Ahmedvini/HyperConv/clockInfo.txt

-------------------------------------
| Tool Version : Vivado v.2025.2
| Date         : Tue Sep 15 03:39:24 2026
| Host         : pop-os
| Design       : design_1
| Device       : xc7z020-clg400-1--
-------------------------------------

For more information on clockInfo.txt clock routing debug file see https://support.xilinx.com/s/article/000035660?language=en_US
