Ahmedvini/HyperConv/bitstream/impl_1/.vivado.begin.rst

<?xml version="1.0"?>
<ProcessHandle Version="1" Minor="0">
    <Process Command="vivado" Owner="ahmedelsheikh" Host="pop-os" Pid="770740" HostCore="12" HostMemory="16089012">
    </Process>
</ProcessHandle>
