Ahmedvini/HyperConv/docs/Images/base/package-view.png

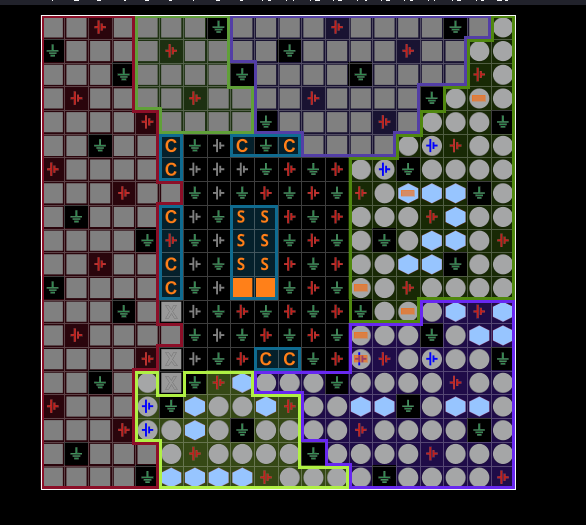
docs/Images/base/package-view.png
