Ahmedvini/HyperConv/docs/Images/base/schematic.png

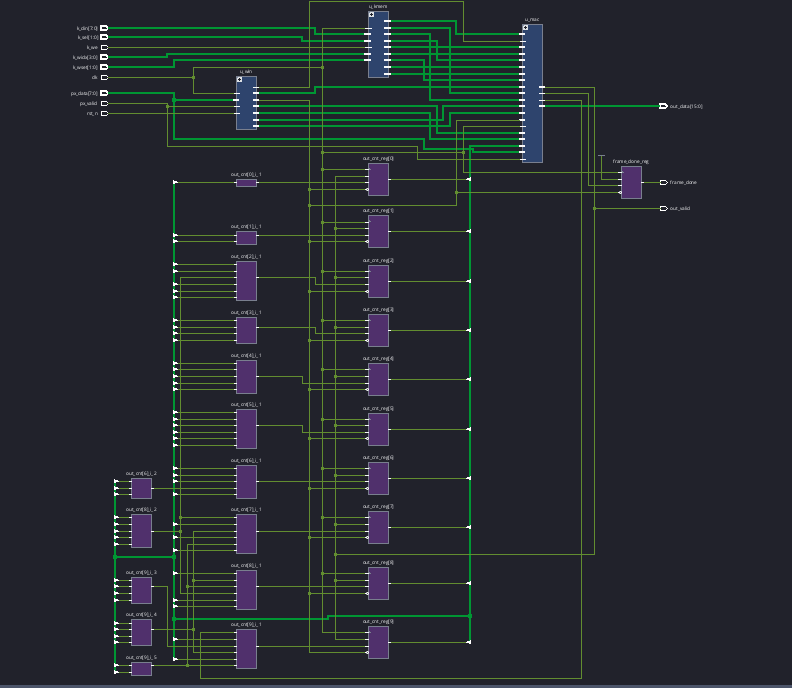
docs/Images/base/schematic.png
