Ahmedvini/HyperConv/(commit log)

2026-07-08 Add Sobel filter test cases and synthesis scripts
    - Introduced new test images and expected output files for Sobel X and Y filters.
    - Added hex files for input images, kernels, and expected outputs.
    - Created parameter script for Sobel Y tests to define image dimensions and kernel settings.
    - Implemented a build script for synthesis of the convolution top module with out-of-context constraints.
    - Added a testbench for the convolution top module to validate functionality against expected outputs.
    - Included XDC constraints for the ZCU106 target to set clock parameters.
2026-07-09 Add self-test functionality and board integration for standalone demo
2026-09-14 Update README, report skeleton, and RTL files for PYNQ-Z2 support; adjust clock constraints and pipeline stages
2026-09-14 Update clockInfo.txt date and remove unnecessary load settings in board.xdc
2026-09-14 Update latency and power metrics in documentation; adjust clockInfo.txt date
2026-09-14 Add ReLU test cases for negative and random inputs
    - Created new test files for ReLU negative inputs including img.hex, kernel.hex, and params.sh.
    - Added expected output for random inputs in expected.hex.
    - Introduced img.hex, kernel.hex, and params.sh for random inputs.
    - Each test case is configured with parameters for dimensions and activation functions.
2026-09-14 Update device and package view images for improved documentation clarity
2026-09-14 Add synthesis reports and scripts for board_top design
    - Created board_top_utilization_synth.rpt to report utilization metrics.
    - Added gen_run.xml to define the synthesis run configuration and file dependencies.
    - Included htr.txt for a repeatable run description of the Vivado synthesis process.
    - Generated rundef.js for WSH script execution with environment setup.
    - Added runme.bat for Windows batch execution of the synthesis process.
    - Created runme.sh for UNIX-based execution of the synthesis process.
2026-09-14 Remove synthesized report files and associated scripts from the bitstream directory. Update board constraints to specify package pins for clock, reset, and status LEDs.
    [board.xdc]
2026-09-15 Add isolated DMP dual-multiply packing experiment (Step 1-2)
    Packs two u8 pixels into the DSP48E1 25-bit A port (stride 16) with a
    single shared s8 coefficient in B: one DSP computes both products.
    Extraction: low field is exact s16; high field needs a +1 borrow
    correction (+prod[15]).
    Verified: 101,276 vectors (all corners incl. 255*-128, full coeff sweep,
    100k random, continuous + gapped valids) - 0 errors.
    Synthesis (xc7z020clg400-1): exactly 1 DSP48E1 inferred, 3 LUT / 36 FF.
    Note: arbitrary two-product packing (separate coeffs) is infeasible on
    DSP48E1 (18-bit B port forces stride <= 10 -> cross-term contamination);
    shared-coefficient packing maps exactly onto two adjacent windows of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
    [dmp_probe.v, ooc.xdc, tb_dmp_probe.v]
2026-09-15 Add hybrid 2-px/cycle architecture: window_gen_2px + dmp_mac_array + conv_top_hybrid
    - window_gen_2px: even/odd interleaved LUTRAM line buffers (zero BRAM),
    (N+1)-wide row shifter, two adjacent windows per beat
    - dmp_mac_array: 9 packed DSP multiplies (both windows share coeffs),
    extraction + borrow correction, two adder trees, dual saturate/ReLU
    - conv_top_hybrid: same feature set as baseline, 2 px in / 2 px out
    - tb_conv_top_hybrid + run_all_hybrid.sh: reuses all 11 golden testcases
    Verified: 11/11 PASS bit-exact (gaps, n5, saturation, ReLU, Sobel).
    Pipeline latency 7 cycles (1 window + 6 MAC).
    [conv_top_hybrid.v, dmp_mac_array.v, tb_conv_top_hybrid.v, window_gen_2px.v]
2026-09-15 Add hybrid board-demo wrapper: selftest_top_hybrid + board_top_hybrid + bitstream flow
    - selftest_top_hybrid: streams the stored image as px0/px1 pairs, compares
    both beat outputs on-chip against the SAME expected.hex as baseline
    - board_top_hybrid: identical pin usage to board_top (reuses board.xdc)
    - tb_selftest_hybrid: sim PASS (542 cycles, ~2x faster than baseline's
    ~1030 - confirms 2-px operation)
    - build_bitstream_hybrid.tcl: sobel_x demo built for PYNQ-Z2:
    579 LUT / 597 FF / 9 DSP / 0 BRAM, WNS +3.068 @ 100 MHz, DRC clean
    (ZPS7-1 advisory only, same as baseline), 4.0 MB bitstream.
2026-09-15 Docs: hybrid board-demo results (sim PASS 542 cyc, bitstream built, board.xdc reused)
2026-09-15 Ignore stray clockInfo in hybrid board build dir
2026-09-15 Upgrade hybrid architecture diagram with full internals
    - expanded mac_array / dmp_mac_array sub-blocks (packed DSPs, extraction
    + borrow fix, dual adder trees, dual sat/ReLU)
    - pipeline stage rulers (6 baseline / 7 hybrid) with per-stage labels
    - DMP packing equation panel, verification + board-demo footnote
    - fixed label/stat line collisions
2026-09-15 Reorganize Vivado images into base/ + hybrid/, update all docs
    - docs/Images/base/: baseline utilization/timing/power/methodology,
    device/package views, schematic, waveforms
    - docs/Images/hybrid/: hybrid OOC report captures (365 LUT, WNS +0.502,
    0.164 W) + device/package/schematic views
    - README: implementation-reports section now PYNQ-Z2 hybrid images with
    baseline device view alongside (was stale ZCU106 captures)
    - report_skeleton: §5 baseline report screenshots table, §8 hybrid report
    + device/package/schematic screenshots table
    - presentation: slide 3 uses hybrid schematic, results slide gets a
    hybrid util/timing/device-view strip, new 'Implementation views' slide
    (schemati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
2026-09-15 Refresh board-build reports (GUI re-run, identical results: 579 LUT / WNS +3.068)
    Re-running build_bitstream_hybrid via the Vivado GUI reproduced the batch
    numbers exactly - only report timestamps differ.
